Severson-Group/CHP-Gen-Drive-Schematic/README.md

# CHP-Gen-Drive-Schematic
Schematics of generator drive system

Describes interconnects between sub-systems, e.g. interface from AMDC to Semikron power stack.
