Severson-Group/CHP-Gen-Drive-Schematic/DOE_CHP_DriveSystem/Project Outputs for DOE_CHP_DriveSystem/DOE_CHP_DriveSystem_BOM.xlsx

Comment | Description | Designator | Qnty
DIN_PSU_5Vdc |  |  | 1
NMA0515 | Module DC-DC 5VIN 2-OUT 15V/-15V 0.033A/-0.033A 1W 5-Pin SIP Tube |  | 1
DIN_PSU_15Vdc | 15VDC power supply | *1 | 1
AMDS measurement system | AMDS measurement system to be combined with AMDC for motor control | *?, AMDS_1 | 2
DIN_PSU_24Vdc | 24Vdc power supply from 115Vac in | [NoValue], *2, *3, *4 | 4
AMDS_ADC_Curr | AMDS current measurement card | [NoValue], AMDS_Curr_ADC_1 | 2
AMDS_ADC_HV | High voltage measurement card | [NoValue], AMDS_HV_ADC_1 | 2
Wago 260 | 28-16 AWG Spring Clamp Terminal Block - DIN Mountable, 28-16AWG Spring Clamp Terminal Block - DIN Mountable | +1, +2, +24Vdc, 24Vdc -, 24Vdc - _2, 24Vdc +, 24Vdc + _2, Gnd, Gnd1, Gnd2, PWM1, PWM2, PWM3, PWM4, PWM?, Tach1, Tach2, Tach3, Tach4 | 24
Bus Bar | Single Connection bus bar | AC1 (U), AC2 (V), AC3 (W), DC -, DC -1, DC -2, DC -?, DC +, DC +1, DC +2, DC +?, Load, Load1, Phase U, Phase U1, Phase V, Phase V1, Phase W, Phase W1 | 21
AMDC | Advanced Motor Drive Controller | AMDC_1 | 2
AMDS_ADC_LV | Low Voltage measurement card | AMDS LV ADC 1, AMDS LV ADC 2, AMDS LV ADC 3, AMDS LV ADC 4, AMDS_LV_ADC_1 | 5
AWHW20G-SMD | ASSMANN WSW AWHW Series, 2.54mm Pitch 20 Way 2 Row Straight PCB Header, Solder Termination, 3A | BrakeChopperConnector, BrakeChopperConnector1 | 2
09185206813 | ASSMANN WSW AWHW Series, 2.54mm Pitch 20 Way 2 Row Straight PCB Header, Solder Termination, 3A | BrakeChopperMateConnector | 1
Capacitor 1 uF +/- 10% 16 V 0603 | Chip Capacitor, 1 uF, +/- 10%, 16 V, 0603 (1608 Metric) | C1, C2 | 2
2-338069-0 | Conn FFC Connector F 20 POS 2.54mm Solder ST SMD T/R | ControlConnection_X1, ControlConnection_X?, LogicInput_X1 | 3
Molex 22-11-1041 | Headers & Wire Housings 2.5MM VERT 4P HDR W/FRICTION RAMP AU | Current Sense U, Current Sense V, Current Sense W, CurrSense U, CurrSense U2, CurrSense V, CurrSense V2, CurrSense W, CurrSense W2 | 9
Molex 5051-04 | Headers & Wire Housings 2.5MM VERT 4P HDR W/FRICTION RAMP AU | CurrSense U1, CurrSense V1, CurrSense W1 | 3
BZX79C4V7-T50A | Zener Diode, 3.6 V, 5 mA, -65 to 200 degC, 2-Pin DO-35, RoHS, Bulk | D1 | 1
B5819W | Schottky Barrier Rectifier, 40 V, 1 A, -65 to 125 degC, 2-Pin SOD123, RoHS, Tape and Reel | D2, D3 | 2
FAULT | Red LED, 80 mW, 30 mA, -25 to 85 degC, 2-Pin THD | DS1 | 1
Connector 15 | Receptacle Assembly, 15-Pin, Sim Line Connector | J1, J2, J3, J4 | 4
2-215083-0 | Header, 20-Pin | P1 | 1
Semikron_SKS_170F_B6Ci_141_V12_IO | IO connections of Semikron power stack. Intended to route to connectors used on the power stack such that external connecting equipment can be shown in schematic form w/ appropriate mating connector. | PowerStack_1, SemikronPwrStck | 2
MFR-25FBF52-1K | Axial Resistor, 1 KOhm, +/- 1%, 250 mW, -55 to 155 degC, 2-Pin THD, RoHS, Bulk | R1 | 1
4D7R5J | 4R7 0.125W 5% 0805 (2012 Metric) SMD | R2, R3, R4, R5, R7, R8, R9, R10, R11, R12, R13 | 11
MFR-25FBF52-100R | Axial Resistor, 100 Ohm, +/- 1%, 0.25 W, -55 to 155 degC, 2-Pin THD, RoHS, Bulk | R6 | 1
Semikron_BrakeChopper | Integrated buck device w/ heatsink | SemikronBrakeChop, SemikronBrakeChop1 | 2
RESET | Tactile Switch, SPST-NO, 0.05 A, 12 V, -25 to 70 degC, 2-Pin SMD, RoHS, Tape and Reel | SW1 | 1
SN74HC02N | IC Quad 2i/p NOR gate, 74HC02N DIP14 2-6V | U1 | 1
SN74ACT14N | 6-ch, 4.5-V to 5.5-V inverters with Schmitt-Trigger inputs 14-PDIP -40 to 85 | U2 | 1
MCP1407 | Microchip MCP1407-E/P; MOSFET Power Driver 6A; 4.5 to 18V; Non-Inverting; 8-Pin PDIP | U3 | 1
