Severson-Group/CHP-Gen-Drive-Schematic/BoundaryIOP.xlsx

Sheet: Semikron_Stack
Group | Designator | Description | Type | Specification | Connector | Pin | Mating Connector | Wire Gauge | Component P/N | Notes
Fan | +24Vdc | Fan Power | Power | 20.4-27.6 V, 1.5A | Wago 260 | 1 | N/A | 28-16 AWG | SanAce: 9GV1224P1J01
Fan | +24Vdc | Fan Power | Power | 20.4-27.6 V, 1.5A | Wago 260 | 1
Fan | Gnd | Fan Power | Power | Ground | Wago 260 | 2
Fan | Gnd | Fan Power | Power | Ground | Wago 260 | 2
Fan | Tach1 | Fan RPM sense | Output | Open Collector 27.6V, 10mA max, 2 ppRev | Wago 260 | 3 |  |  |  | Connected to AMDC 5v via 1K ohm
Fan | PWM1 | Fan speed control | Input | TTL, 5.25V max, 25KHz, | Wago 260 | 4 |  |  |  | Connected to AMDC 5v via 1K ohm
Fan | Tach2 | Fan RPM sense | Output | Open Collector 27.6V, 10mA max, 2 ppRev | Wago 260 | 5 |  |  |  | Connected to AMDC 5v via 1K ohm
Fan | PWM2 | Fan speec control | Input | TTL, 5.25V max, 25KHz, | Wago 260 | 6 |  |  |  | Connected to AMDC 5v via 1K ohm
DCLink | DC+ | DC Link positive x4 | Power | Abs Max 1,000Vdc | Bus Bar | 2,3,5,6 | 9.5mm bolt
DCLink | DC- | DC link negative x3 | Power |  | Bus Bar | 1,4,7
Phase | AC1 (U) | Phase U connection | Power |  | Bus Bar | 1 | 9mm bolt
Phase | AC2 (V) | Phase V connection | Power |  | Bus Bar | 2
Phase | AC3 (W) | Phase W connection | Power |  | Bus Bar | 3
CT1 (U) | V_ref | Output signal reference | Output | 2.5V +/- 0.025v | Molex KK 2.5mm 4-pin | 1 | Molex PN 5051-04 | 22-30 AWG | LEM Hass-100-S
CT1 (U) | Output (U) | Current sense output (U) | Output | 6.25mV/A + Vref, +/- 0.015 | Molex KK 2.5mm 4-pin | 2
CT1 (U) | 0V | Ground | Power | PS ground | Molex KK 2.5mm 4-pin | 3
CT1 (U) | +5v | Power Supply | Power | 5V +/-5%, 25mA max | Molex KK 2.5mm 4-pin | 4 |  |  |  | Provided by AMDS Daughter Header
CT2 (V) | V_ref | Output signal reference | Output | 2.5V +/- 0.025v | Molex KK 2.5mm 4-pin | 1 | Molex PN 5051-04 | 22-30 AWG | LEM Hass-100-S
CT2 (V) | Output (V) | Current sense output (V) | Output | 6.25mV/A + Vref, +/- 0.015 | Molex KK 2.5mm 4-pin | 2
CT2 (V) | 0V | Ground | Power | PS ground | Molex KK 2.5mm 4-pin | 3
CT2 (V) | +5v | Power Supply | Power | 5V +/-5%, 25mA max | Molex KK 2.5mm 4-pin | 4 |  |  |  | Provided by AMDS Daughter Header
CT3 (W) | V_ref | Output signal reference | Output | 2.5V +/- 0.025v | Molex KK 2.5mm 4-pin | 1 | Molex PN 5051-04 | 22-30 AWG | LEM Hass-100-S
CT3 (W) | Output (W) | Current sense output (W) | Output | 6.25mV/A + Vref, +/- 0.015 | Molex KK 2.5mm 4-pin | 2
CT3 (W) | 0V | Ground | Power | PS ground | Molex KK 2.5mm 4-pin | 3
CT3 (W) | +5v | Power Supply | Power | 5V +/-5%, 25mA max | Molex KK 2.5mm 4-pin | 4 |  |  |  | Provided by AMDS Daughter Header
Control Connection X1 | IF_PWR_VP | Gate Drive Power Supply Positive | Power | 15V +/- 4% | Tyco Micromatch 20 pin | 1 | Tyco PN 2-215083-0 | 28 AWG Ribbon
Control Connection X1 | IF_PWR_VP | Gate Drive Power Supply Positive | Power | 15V +/- 4% |  | 2 |  |  |  | Provided by AMDC Pass Through
Control Connection X1 | IF_CMN_DCLINK_P | Differential DC Link V sense Positive | Output | 0-10V, 3mV/V, +/- 2.5% |  | 3
Control Connection X1 | IF_CMN_DCLINK_N | Differential DC Link V sense Negative | Output |  |  | 4
Control Connection X1 | - | Not Used |  |  |  | 5
Control Connection X1 | - | Not Used |  |  |  | 6
Control Connection X1 | IF_CMN_GND | Gate Drive & PWM Ground | Power | Ground |  | 7
Control Connection X1 | IF_CMN_HB1_TOP | Gate Signal, TOP, Phase U | Input | 15V CMOS Input |  | 8
Control Connection X1 | IF_CMN_HB1_BOT | Gate Signal, BOT, Phase U | Input | 15V CMOS Input |  | 9
Control Connection X1 | IF_CMN_HB2_TOP | Gate Signal, TOP, Phase V | Input | 15V CMOS Input |  | 10
Control Connection X1 | IF_CMN_HB2_BOT | Gate Signal, BOT, Phase V | Input | 15V CMOS Input |  | 11
Control Connection X1 | IF_CMN_HB3_TOP | Gate Signal, TOP, Phase W | Input | 15V CMOS Input |  | 12
Control Connection X1 | IF_CMN_HB3_BOT | Gate Signal, BOT, Phase W | Input | 15V CMOS Input |  | 13
Control Connection X1 | IF_CMN_GND | Gate Drive & PWM Ground | Power | Ground |  | 14
Control Connection X1 | IF_CMN_ERR | Gate Driver error output | Output | Open collector, LOW = ERROR, max 30mA |  | 15
Control Connection X1 | - | Not Used |  |  |  | 16
Control Connection X1 | - | Not Used |  |  |  | 17
Control Connection X1 | - | Not Used |  |  |  | 18
Control Connection X1 | IF_CMN_GND | Gate Drive & PWM Ground | Power | Ground |  | 19
Control Connection X1 | IF_CMN_GND | Gate Drive & PWM Ground | Power | Ground |  | 20

Sheet: Semikron_Chopper
Group | Designator | Description | Type | Specification | Connector | Pin | Mating Connector | Wire Gauge | Component P/N | Notes
DC link | 1- | Negative DC link connection, Anode of diode | Power_In | abs max 1,200V, 652A | M6 - 2.5-5Nm, 6.5-10mm length | 1 | M6 8mm bolt |  | SEMiX703GAR126HDs
DC link | 2+ | Positive DC link connection, Drain/Collector of switching device. | Power_In | abs max 1,200V, 652A | M6 - 2.5-5Nm, 6.5-10mm length | 2 | M6 8mm bolt
Load | 3 | AC link connection/Resitive load connection, Emitter of switching device/Cathode of diode | Power_Out |  | M6 - 2.5-5Nm, 6.5-10mm length | 3 | M6 8mm bolt
Load | 4 | same as Load 3 | Power_Out |  | M6 - 2.5-5Nm, 6.5-10mm length | 4 | M6 8mm bolt
Control - X20 | IF_PWR_15P | Drive Power Supply | Power_In | +15V +/-45% | Assmann AWHW 20G SMD | 1 | 09185206813 | 20 x AWG 26-28 Ribbon | 3s SKYPER 32 PRO R Gold | Provided by AMDC Pass Through
Control - X20 | IF_PWR_GND | Ground for power supply | Power_In | Gnd |  | 2
Control - X20 | IF_PWR_15P | Drive Power Supply | Power_In | +15V +/-45% |  | 3
Control - X20 | IF_PWR_GND | Ground for power supply | Power_In | Gnd |  | 4
Control - X20 | IF_PWR_15P | Drive Power Supply | Power_In | +15V +/-45% |  | 5
Control - X20 | IF_PWR_GND | Ground for power supply | Power_In | Gnd |  | 6
Control - X20 | reserved |  | - | - |  | 7
Control - X20 | IF_PWR_GND | Ground for power supply | Power_In | Gnd |  | 8
Control - X20 | IF_CMN_nHALT | Drive core status signal (Bidirectional signal w/ dominant recessive behavior) | I/O | Digital 15V logic. LOW(dominant) = driver disabled. HIGH(recessive) = ready to operate |  | 9
Control - X20 | reserved | - | - | - |  | 10
Control - X20 | reserved | - | - | - |  | 11
Control - X20 | IF_CMN_GND | Ground for signal IF_CMN_nHALT | I/O | Gnd for nHalt |  | 12
Control - X20 | reserved | - | - | - |  | 13
Control - X20 | reserved | - | - | - |  | 14
Control - X20 | IF_HB_TOP | Switching signal input (TOP switch) | Input | Digital 15V logic. 10Kohm impedance. LOW = TOP switch off |  | 15
Control - X20 | IF_HB_BOT | Switching signal input (BOT switch) | Input | Digital 15V logic. 10Kohm impedance. LOW = BOT switch off |  | 16
Control - X20 | reserved | - | - | - |  | 17
Control - X20 | IF_HB_GND | Ground for signals IF_HB_TOP and IF_HB_BOT | Input | Ground for gate signals |  | 18
Control - X20 | reserved | - | - | - |  | 19
Control - X20 | reserved | - | - | - |  | 20

Sheet: AMDC
Group | Designator | Description | Type | Specification | Connector | Pin | Mating Connector | Wire Gauge | Component P/N | Notes
Power | Vin | +24Vdc AMDC Logic Power | Power_In | 20-34Vdc, 0.5A | 1x2 screw terminal | 1 | N/A | 12-26AWG
Power | Gnd_In | Ground | Power | Ground, isolated |  | 2
Vdrive | Vdrive | PWM voltage source positive | Power_In | 5-18Vdc | 1x2 screw terminal | 1 | N/A | 12-26AWG
Vdrive | Gnd_drive | PWM voltage source gnd | Power | Ground |  | 2
Vps | Vps | Gate Driver PS Positive- Pass through | Power_In | 2A max | 1x2 screw terminal | 1 | N/A | 12-26AWG
Vps | Gnd_ps | Gate Driver PS Ground - pass through | Power | Ground |  | 2
Estop | Estop_out | E-stop sense line out | Output | closed ckt, drive enabled | 1x2 screw terminal | 1 | N/A | 12-26AWG
Estop | Estop_in | E-stop sense line In | Input |  |  | 2
InverterCntrl1 | INV1_PWM1 | Inverter 1 PWM output 1 | Output | PWM bridge signal, level determined by Vdrive | 3 Row DB-15 - Female | 1 | 3 Row DB-15 Male | 24-28 AWG |  | Rinse Repeat x8
InverterCntrl1 | INV1_PWM2 | Inverter 1 PWM output 2 | Output | PWM bridge signal, level determined by Vdrive |  | 2 |  |  |  | Top is odd, Bottom is Even on stacked DB-15
InverterCntrl1 | INV1_PWM3 | Inverter 1 PWM output 3 | Output | PWM bridge signal, level determined by Vdrive |  | 3
InverterCntrl1 | INV1_PWM4 | Inverter 1 PWM output 4 | Output | PWM bridge signal, level determined by Vdrive |  | 4
InverterCntrl1 | INV1_PWM5 | Inverter 1 PWM output 5 | Output | PWM bridge signal, level determined by Vdrive |  | 5
InverterCntrl1 | INV1_PWM6 | Inverter 1 PWM output 6 | Output | PWM bridge signal, level determined by Vdrive |  | 6
InverterCntrl1 | Gnd | Inverter PWM ground reference | Power_Out | Vdrive ground |  | 7
InverterCntrl1 | STS_A_1 | Inverter Status A | I/O | 3.3 or 5v Vdd ref, can be set as Input or Output |  | 8 |  |  |  | Single jumper det'ns I or O for A-D
InverterCntrl1 | STS_B_1 | Inverter Status B | I/O | 3.3 or 5v Vdd ref, can be set as Input or Output |  | 9
InverterCntrl1 | STS_C_1 | Inverter Status C | I/O | 3.3 or 5v Vdd ref, can be set as Input or Output |  | 10
InverterCntrl1 | STS_D_1 | Inverter Status D | I/O | 3.3 or 5v Vdd ref, can be set as Input or Output |  | 11
InverterCntrl1 | Vps | Gate driver PS positive | Power_In | 2A max |  | 12
InverterCntrl1 | Vdd | Status reference V output | Power_Out | Set either 3.3 or 5V via jumper |  | 13
InverterCntrl1 | Gnd_ps | Gate driver PS Ground | Power_In | Ground |  | 14
InverterCntrl1 | Gnd | Status reference V output Gnd | Power_Out | Status ref ground |  | 15
Analog1 | Analog_P1 | Differential Analog ADC Positive input 1 | Input | +/-10V differential signal | RJ-45 - Female | 1 | RJ45 - Male | 22-24 AWG |  | Rinse Repeat x4
Analog1 | Analog_N1 | Differential Analog ADC Negative input 1 | Input |  |  | 2
Analog1 | Vanalog_P | +15V analog measurement positive voltage | Power_Out | +15Vdc reference signal from AMDC |  | 3
Analog1 | Gnd | Ground | Power_Out | analog measurement power ground |  | 4
Analog1 | Vanalog_N | -15V analog measurement negative voltage | Power_Out | -15Vdc reference signal from AMDC |  | 5
Analog1 | Gnd | Ground | Power_Out | analog measurement power ground |  | 6
Analog1 | Analog_P2 | Differential Analog ADC Positive input 2 | Input | +/-10V differential signal |  | 7
Analog1 | Analog_N2 | Differential Analog ADC Negative input 2 | Input |  |  | 8
Encoder1 | A | Differential encoder A positive | Input | 0-5V unipolar | DB9 - Female | 1 | DB9 - Male | 24-28 AWG |  | Rinse Repeat x2
Encoder1 | !A | Differential encoder A negative | Input |  |  | 2
Encoder1 | B | Differential encoder B positive | Input | 0-5V unipolar |  | 3
Encoder1 | !B | Differential encoder B negative | Input |  |  | 4
Encoder1 | Z | Differential encoder Z positive | Input | 0-5V unipolar |  | 5
Encoder1 | !Z | Differential encoder Z negative | Input |  |  | 6
Encoder1 | 5V | Optional +5V encoder power | Power_Out | Short JP2/JP3 to enable power to Encoder1 or 2 |  | 7
Encoder1 | GND | encoder ground | Power_Out |  |  | 8
Encoder1 | GND | encoder ground | Power_Out |  |  | 9
GPIO1 | +5V |  | Power_Out | +5Vdc output | 3 Row DB-15 - Female | 1 | 3 Row DB-15 Male | 24-28 AWG |  | Rinse Repeat x4
GPIO1 | GPIO1_IN1_P | Differential GPIO In1 positive | Input | 0-5V unipolar |  | 2
GPIO1 | GPIO1_IN1_N | Differential GPIO In1 negative | Input |  |  | 3
GPIO1 | GPIO1_IN2_P | Differential GPIO In2 positive | Input | 0-5V unipolar |  | 4
GPIO1 | GPIO1_IN2_N | Differential GPIO In2 negative | Input |  |  | 5
GPIO1 | +24V |  | Power_Out | +24Vdc output |  | 6
GPIO1 | GPIO1_IN3_P | Differential GPIO In3 positive | Input | 0-5V unipolar |  | 7
GPIO1 | GPIO1_IN3_N | Differential GPIO In3 negative | Input |  |  | 8
GPIO1 | GPIO1_OUT3_P | Differential GPIO Out3 positive | Output | 0-5V unipolar |  | 9
GPIO1 | GPIO1_OUT3_N | Differential GPIO Out3 negative | Output |  |  | 10
GPIO1 | Gnd |  | Power_Out |  |  | 11
GPIO1 | GPIO1_OUT1_P | Differential GPIO Out1 positive | Output | 0-5V unipolar |  | 12
GPIO1 | GPIO1_OUT1_N | Differential GPIO Out1 negative | Output |  |  | 13
GPIO1 | GPIO1_OUT2_P | Differential GPIO Out2 positive | Output | 0-5V unipolar |  | 14
GPIO1 | GPIO1_OUT2_N | Differential GPIO Out2 negative | Output |  |  | 15
JTAG/UART | JTAG_UART | JTAG & UART combo interface | I/O | USB | USB-B | - | USB
Ethernet | ETHERNET | Ethernet expansion | I/O | Ethernet | RJ45 - Female | - | RJ-45 - Male

Sheet: AMDS
Group | Designator | Description | Type | Specification | Connector | Pin | Mating Connector | Wire Gauge | Component P/N | Notes
Power | +24V | Main board positive power | Power_In | 18-36V in | 1x2 screw terminal | 1 |  | 12-26AWG
Power | Gnd | Main board ground power | Power_In | Gnd |  | 2
COMM | 5V_in | Isolated supply voltage | Power_In | 4.5-5.5V | DB 15 - 3 row - Female | 1 | DB 15 - 3 Row - Male | 24-28 AWG |  | *Uart 1 is ADC sync
COMM | UART1_PKT_Rtrn_P | Return ADC data 1 from AMDS to AMDC, diff output, P | Output | 0-5V_in |  | 2 |  |  |  | *Uart 2 is Data Tx
COMM | UART1_PKT_Rtrn_N | Return ADC data 1 from AMDS to AMDC, diff output, N | Output | 0-5V_in |  | 3
COMM | UART2_PKT_Rtrn_P | Return ADC data 2 from AMDS to AMDC, diff output, P | Output | 0-5V_in |  | 4
COMM | UART2_PKT_Rtrn_N | Return ADC data 2 from AMDS to AMDC, diff output, P | Output | 0-5V_in |  | 5
COMM | - | No connection |  |  |  | 6
COMM | isoSPI2_P | Not Used: iso SPI 2 differential input, Positive | I/O | 0-5V_in |  | 7
COMM | isoSPI2_N | Not Used: iso SPI 2 differential input, Negative | I/O | 0-5V_in |  | 8
COMM | isoSPI3_P | Not Used: iso SPI 3 differential input, Positive | I/O | 0-5V_in |  | 9
COMM | isoSPI3_N | Not Used: iso SPI 3 differential input, Negative | I/O | 0-5V_in |  | 10
COMM | GND | Ground | Power_In | 0V |  | 11
COMM | ADC_Sync_P | ADC Sync differential input, Positive | Input | +/- 0-12V, 54-60Ohm |  | 12
COMM | ADC_Sync_N | ADC Sync differential input, Negative | Input | +/- 0-12V, 54-60Ohm |  | 13
COMM | UART_Pkt_Req_P | UART PKT Sync differential input, Positive | Input | +/- 0-12V, 54-60Ohm |  | 14
COMM | UART_Pkt_Req_N | UART PKT Sync differential input, Negative | Input | +/- 0-12V, 54-60Ohm |  | 15
GPIO | 3v3 | 3.3v GPIO voltage out | Power_Out |  | DB 15 - 3 row - Female | 1 | DB 15 - 3 Row - Male | 24-28 AWG
GPIO | GPIO_1 | GPIO | I/O | 3.0-3.6V |  | 2
GPIO | GPIO_2 | GPIO | I/O | 3.0-3.6V |  | 3
GPIO | GPIO_3 | GPIO | I/O | 3.0-3.6V |  | 4
GPIO | GPIO_4 | GPIO | I/O | 3.0-3.6V |  | 5
GPIO | GPIO_5 | GPIO | I/O | 3.0-3.6V |  | 6
GPIO | GPIO_6 | GPIO | I/O | 3.0-3.6V |  | 7
GPIO | GPIO_7 | GPIO | I/O | 3.0-3.6V |  | 8
GPIO | GPIO_8 | GPIO | I/O | 3.0-3.6V |  | 9
GPIO | GPIO_9 | GPIO | I/O | 3.0-3.6V |  | 10
GPIO | GPIO_10 | GPIO | I/O | 3.0-3.6V |  | 11
GPIO | GPIO_11 | GPIO | I/O | 3.0-3.6V |  | 12
GPIO | GPIO_12 | GPIO | I/O | 3.0-3.6V |  | 13
GPIO | GND | Ground | Power_Out |  |  | 14
GPIO | GND | Ground | Power_Out |  |  | 15
DC1 | +15V | Daughter card +15v power | Power_In | +15Vdc +/-5% LV25 supply signal | 1x3 pin header | 1 | 1x3 pin header | board 2 board |  | total of 8 Daughter cards
DC1 | Gnd | Daughter card power gnd | Power_In | ground |  | 2
DC1 | -15V | Daughter card -15V power | Power_In | -15Vdc +/-5% LV25 supply signal |  | 3
DC1 | 5V | Daughter card 5V power | Power_Out | 5v | 1x7 pin header | 1 | 1x7 pin header | board 2 board
DC1 | 3v3 | Daughter card 3v3 power | Power_Out | 3.3v |  | 2
DC1 | GND | Daughter card gnd | Power_Out | ground |  | 3
DC1 | DIN | Daughter card serial comm in | Input | 3.3v max Spi data in |  | 4
DC1 | DOUT | Daughter card serial comm out | Output | 3.3v, Spi data out |  | 5
DC1 | SCLK | Daughter card serial comm clk | Output | 3.3v max, Spi clock Out |  | 6
DC1 | CONVST | Daughter card ADC conversion trigger | Output | 3.3v max, ADC start conv trig |  | 7

Sheet: LV ADC Card
Group | Designator | Description | Type | Specification | Connector | Pin | Mating Connector | Wire Gauge | Component P/N | Notes
Power | +15v | +15v External connection | Power_In | +15Vdc reference signal | 1x3 screw terminal | 1
Power | Gnd | Gnd, External connection | Power_In | ground |  | 2
Power | -15V | -15v External connection | Power_In | -15Vdc reference signal |  | 3
Power | +15v | +15v Native AMDS connection | Power_In | +15Vdc reference signal | 1x3 pin header | 1 |  |  |  | Duplicate w/ alternate connection
Power | Gnd | Gnd, Native AMDS connection | Power_In | ground |  | 2 |  |  |  | +/-15Vdc provided by AMDS
Power | -15V | -15v Native AMDS connection | Power_In | -15Vdc reference signal |  | 3
ADMCIntr | 5V | ADC reference 5V signal - fed into 4.096v ref | Power_In | 5v | 1x7 pin header | 1
ADMCIntr | 3v3 | ADC reference 3.3v signal - fed into 2.048v ref | Power_In | 3.3v |  | 2
ADMCIntr | Gnd | ground ADC comm ref | Power_In | ground |  | 3
ADMCIntr | Din | Digital in | Input | 3.3v max Spi data in |  | 4
ADMCIntr | Sysclk | sysclock | Input | 3.3v max, Spi clock in |  | 5
ADMCIntr | Dout | Digital out | Output | 3.3v, Spi data out |  | 6
ADMCIntr | Convst | ADC sync trigger | Input | 3.3v max, ADC start conv trig |  | 7
Signal | Vin+ | Voltage signal of interest, positive | Input | +/- 15.4v max | 1x2 screw terminal | 1 |  |  |  | ADC val out = 0.1(Vin+ - Vin-)+2.048v
Signal | Vin- | Voltage signal of interest, negative | Input | +/- 15.4v max |  | 2 |  |  |  | Max differential voltage +/- 10v
Signal | Vin+ | Voltage signal of interest, positive | Input | +/- 15.4v max | BNC | 1 |  |  |  | Duplicate w/ alternate connection
Signal | Vin- | Voltage signal of interest, negative | Input | +/- 15.4v max |  | 2

Sheet: HV ADC Card
Group | Designator | Description | Type | Specification | Connector | Pin | Mating Connector | Wire Gauge | Component P/N | Notes
Power | +15v | +15v External connection | Power_In | +15Vdc +/-5% LV25 supply signal | 1x3 screw terminal | 1
Power | Gnd | Gnd, External connection | Power_In | ground |  | 2
Power | -15V | -15v External connection | Power_In | -15Vdc +/-5% LV25 supply signal |  | 3
Power | +15v | +15v Native AMDS connection | Power_In | +15Vdc +/-5% LV25 supply signal | 1x3 screw terminal | 1 |  |  |  | Duplicate w/ alternate connection
Power | Gnd | Gnd, Native AMDS connection | Power_In | ground |  | 2 |  |  |  | +/-15Vdc provided by AMDS
Power | -15V | -15v Native AMDS connection | Power_In | -15Vdc +/-5% LV25 supply signal |  | 3
ADMCIntr | 5V | ADC reference 5V signal - fed into 4.096v ref | Power_In | 5v | 1x7 pin header | 1
ADMCIntr | 3v3 | ADC reference 3.3v signal - fed into 2.048v ref | Power_In | 3.3v |  | 2
ADMCIntr | Gnd | ground ADC comm ref | Power_In | ground |  | 3
ADMCIntr | Din | Digital in | Input | 3.3v max Spi data in |  | 4
ADMCIntr | Sysclk | sysclock | Input | 3.3v max, Spi clock in |  | 5
ADMCIntr | Dout | Digital out | Output | 3.3v, Spi data out |  | 6
ADMCIntr | Convst | ADC sync trigger | Input | 3.3v max, ADC start conv trig |  | 7
Signal | Vin+ | Voltage signal of interest, positive | Input | +/- 500v | Lug terminal | 1 |  |  | LV25-p
Signal | Vin- | Voltage signal of interest, negative | Input | +/- 500v | Lug terminal | 1 |  |  |  | Max differential voltage = +/- 500V

Sheet: Current ADC Card
Group | Designator | Description | Type | Specification | Connector | Pin | Mating Connector | Wire Gauge | Component P/N | Notes
Power | +15v | +15v External connection | Power_In | +15Vdc +/-5% LA55 supply signal | 1x3 screw terminal | 1
Power | Gnd | Gnd, External connection | Power_In | ground |  | 2
Power | -15V | -15v External connection | Power_In | -15Vdc +/-5% LA55 supply signal |  | 3
Power | +15v | +15v Native AMDS connection | Power_In | +15Vdc +/-5% LA55 supply signal | 1x3 screw terminal | 1 |  |  |  | Duplicate w/ alternate connection
Power | Gnd | Gnd, Native AMDS connection | Power_In | ground |  | 2 |  |  |  | +/-15Vdc provided by AMDS
Power | -15V | -15v Native AMDS connection | Power_In | -15Vdc +/-5% LA55 supply signal |  | 3
ADMCIntr | 5V | ADC reference 5V signal - fed into 4.096v ref | Power_In | 5v | 1x7 pin header | 1
ADMCIntr | 3v3 | ADC reference 3.3v signal - fed into 2.048v ref | Power_In | 3.3v |  | 2
ADMCIntr | Gnd | ground ADC comm ref | Power_In | ground |  | 3
ADMCIntr | Din | Digital in | Input | 3.3v max Spi data in |  | 4
ADMCIntr | Sysclk | sysclock | Input | 3.3v max, Spi clock in |  | 5
ADMCIntr | Dout | Digital out | Output | 3.3v, Spi data out |  | 6
ADMCIntr | Convst | ADC sync trigger | Input | 3.3v max, ADC start conv trig |  | 7
Signal | Ip+ | Voltage signal of interest, positive | Input | +/- 55Arms (P5) | Lug terminal | 1 |  |  | LA55-p | 1/7 V/A w/ 2.35V bias
Signal | Ip- | Voltage signal of interest, negative | Input | +/- 55Arms (P6) | Lug terminal | 1 |  |  |  | Max current +/-55Arms

Sheet: External PSUs
Component | Voltage | Power | Qnty | Description
AMDC | 24V | <24w |  | Main Logic Power
 | 15V | 15-30w |  | PWM power & Power stack gate drive power pass through
AMDS | 24V | <24w |  | Main Logic Power
Semikron Power stack | 24V | 36w | 2 | Fan power
Semikron Chopper | 15V | 31.5W

Sheet: BOM
Line | Component | Where Used | Status | Mating Connector | Qnty | Supplier Link
10 | TE Connectivity - 2-338069-0 | Semikron Stack gate drive | Received | 2-215083-0 | 1 | https://www.newark.com/amp-te-connectivity/2-215083-0/wtb-conn-header-20pos-2row-1-27mm/dp/23AH0110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
20 | Molex 22-11-1041 | Semikron stack curr sense | Received | 22-01-1042 | 3 | https://www.newark.com/molex/22-01-1042/connector-rcpt-4pos-1row-2-5mm/dp/55H8852?st=22-01-1042
 | LEM Hass-100-S | Semikron stack curr sense | Received | KK 254 Crimp Terminal, 22-30 AWG, Hot Tin (Sn) Dip Plating | 12 | https://www.newark.com/molex/08-50-0114/contact-socket-22awg-crimp/dp/34H3328?MER=sy-me-pd-mi-acce
30 | DC link Power Interface | Semikron Stack | Common Stocked Parts | 9.5mm OD bolt | 7
40 | DC link Power Interface | Semikron Stack | Common Stocked Parts | 9.5mm nut | 7
50 | Phase Power Interface | Semikron Stack | Common Stocked Parts | 9mm Bolt | 3
60 | Phase Power Interface | Semikron Stack | Common Stocked Parts | 9mm nut | 3
70 | Assmann AWHW 20G SMD | Semikron Chopper | Received | 09185206813 | 1 | https://www.newark.com/harting/09185206813/wire-board-connector-female-20/dp/88K2091?ost=09185206813
80 | Power Interface | Semikron Chopper | Common Stocked Parts | M6x8mm bolt | 4
90 | 1m DIN rail | Cabinet | PurReq Sent |  | 1 | https://www.newark.com/weidmuller/0514500000/din-mounting-rail-35mm-x-7-5mm/dp/13P0027
100 | 15V 20W DIN PSU | PWM & Gate drive | PurReq Sent |  | 1 | https://www.newark.com/xp-power/drc30us15/power-supply-ac-dc-15v-2a/dp/82AH6292
110 | 24V 36W DIN PSU | Fans, AMDC & AMDS power | PurReq Sent |  | 4 | https://www.newark.com/xp-power/drc30us24/power-supply-ac-dc-24v-1-5a/dp/82AH6293

Sheet: Interconnect Tracker
 | Connector | Connects to | AWG | Wire Capacity | Voltage | Application Current | HV > 50Vdc
Semikron Stack | Fan | AMDC GPIO1 | 20 | 11 | LV | 1.5 | LV < 50Vdc
 | Fan 24V | PSU 24v 1 & 2 | 24 | 3.5 | LV | Logic
 | DC Link | Chopper | 7 | 89 | HV | 85
 | Phase | Generator | 13 | 35 | HV | 35
 | CT1 (U) | AMDS LVana1 | 24 | 3.5 | LV | Logic
 | CT2 (V) | AMDS LVana3 | 24 | 3.5 | LV | Logic
 | CT3 (W) | AMDS LVana4 | 24 | 3.5 | LV | Logic
 | Control Connection X1 - Control | AMDC Inverter1 | 24 | 3.5 | LV | Logic
 | Control Connection X1 - DC link V | AMDS LVana4 | 24 | 3.5 | LV | Logic
AMDC | 24V Power | PSU 24v 3 | 20 | 11 | LV | <1
 | PWM Power | PSU 15v 1 | 20 | 11 | LV | <1
 | Gate drive power | PSU 15v 1 | 20 | 11 | LV | <1
 | Inverter 1 | Stack - Control | 24 | 3.5 | LV | <1
 | Inverter 5 | Chopper - Control | 24 | 3.5 | LV | <1
 | GPIO 1 | Stack - Fan Control | 24 | 3.5 | LV | <1
AMDS | 24V power | PSU 24v 4 | 20 | 11 | LV | <1
 | AMDS LVana1 | Stack - CT1(U) | 24 | 3.5 | LV | <1
 | AMDS LVana3 | Stack - CT2(V) | 24 | 3.5 | LV | <1
 | AMDS LVana4 | Stack - CT3(W) | 24 | 3.5 | LV | <1
 | AMDS LVana2 | Stack - DC Link Sense | 24 | 3.5 | LV | <1
Semikron Chopper | Control | AMDC Inverter5 | 24 | 3.5 | LV | <1
 | DC Link | Stack - DC Link Power | 7 | 89 | HV | 85
 | Load | Load Bank | 7 | 89 | HV | 85
DC Link Voltage Monitor | DC Link Monitor | DC Link | 24 | 3.5 | HV | <1

Sheet: Power Calcs
Cable Sizing | Power | 10000 | 30000 | 50000 | w
 | Phase voltage (rms) | 480 | 480 | 480 | vac
 | phase current (rms) | 6.94 | 20.83 | 34.72 | Aac
 | DC link Voltage | 600 | 600 | 601 | Vdc
 | DC link Current | 16.67 | 50.00 | 83.19 | Adc

Sheet: Polaris Resistor
Group | Designator | Description | Type | Specification | Connector | Pin | Mating Connector | Wire Gauge | Component P/N | Notes
