Severson-Group/CHP-Gen-Drive-Schematic/DOE_CHP_DriveSystem/CHP-Gen-Drive-Schematic.pdf

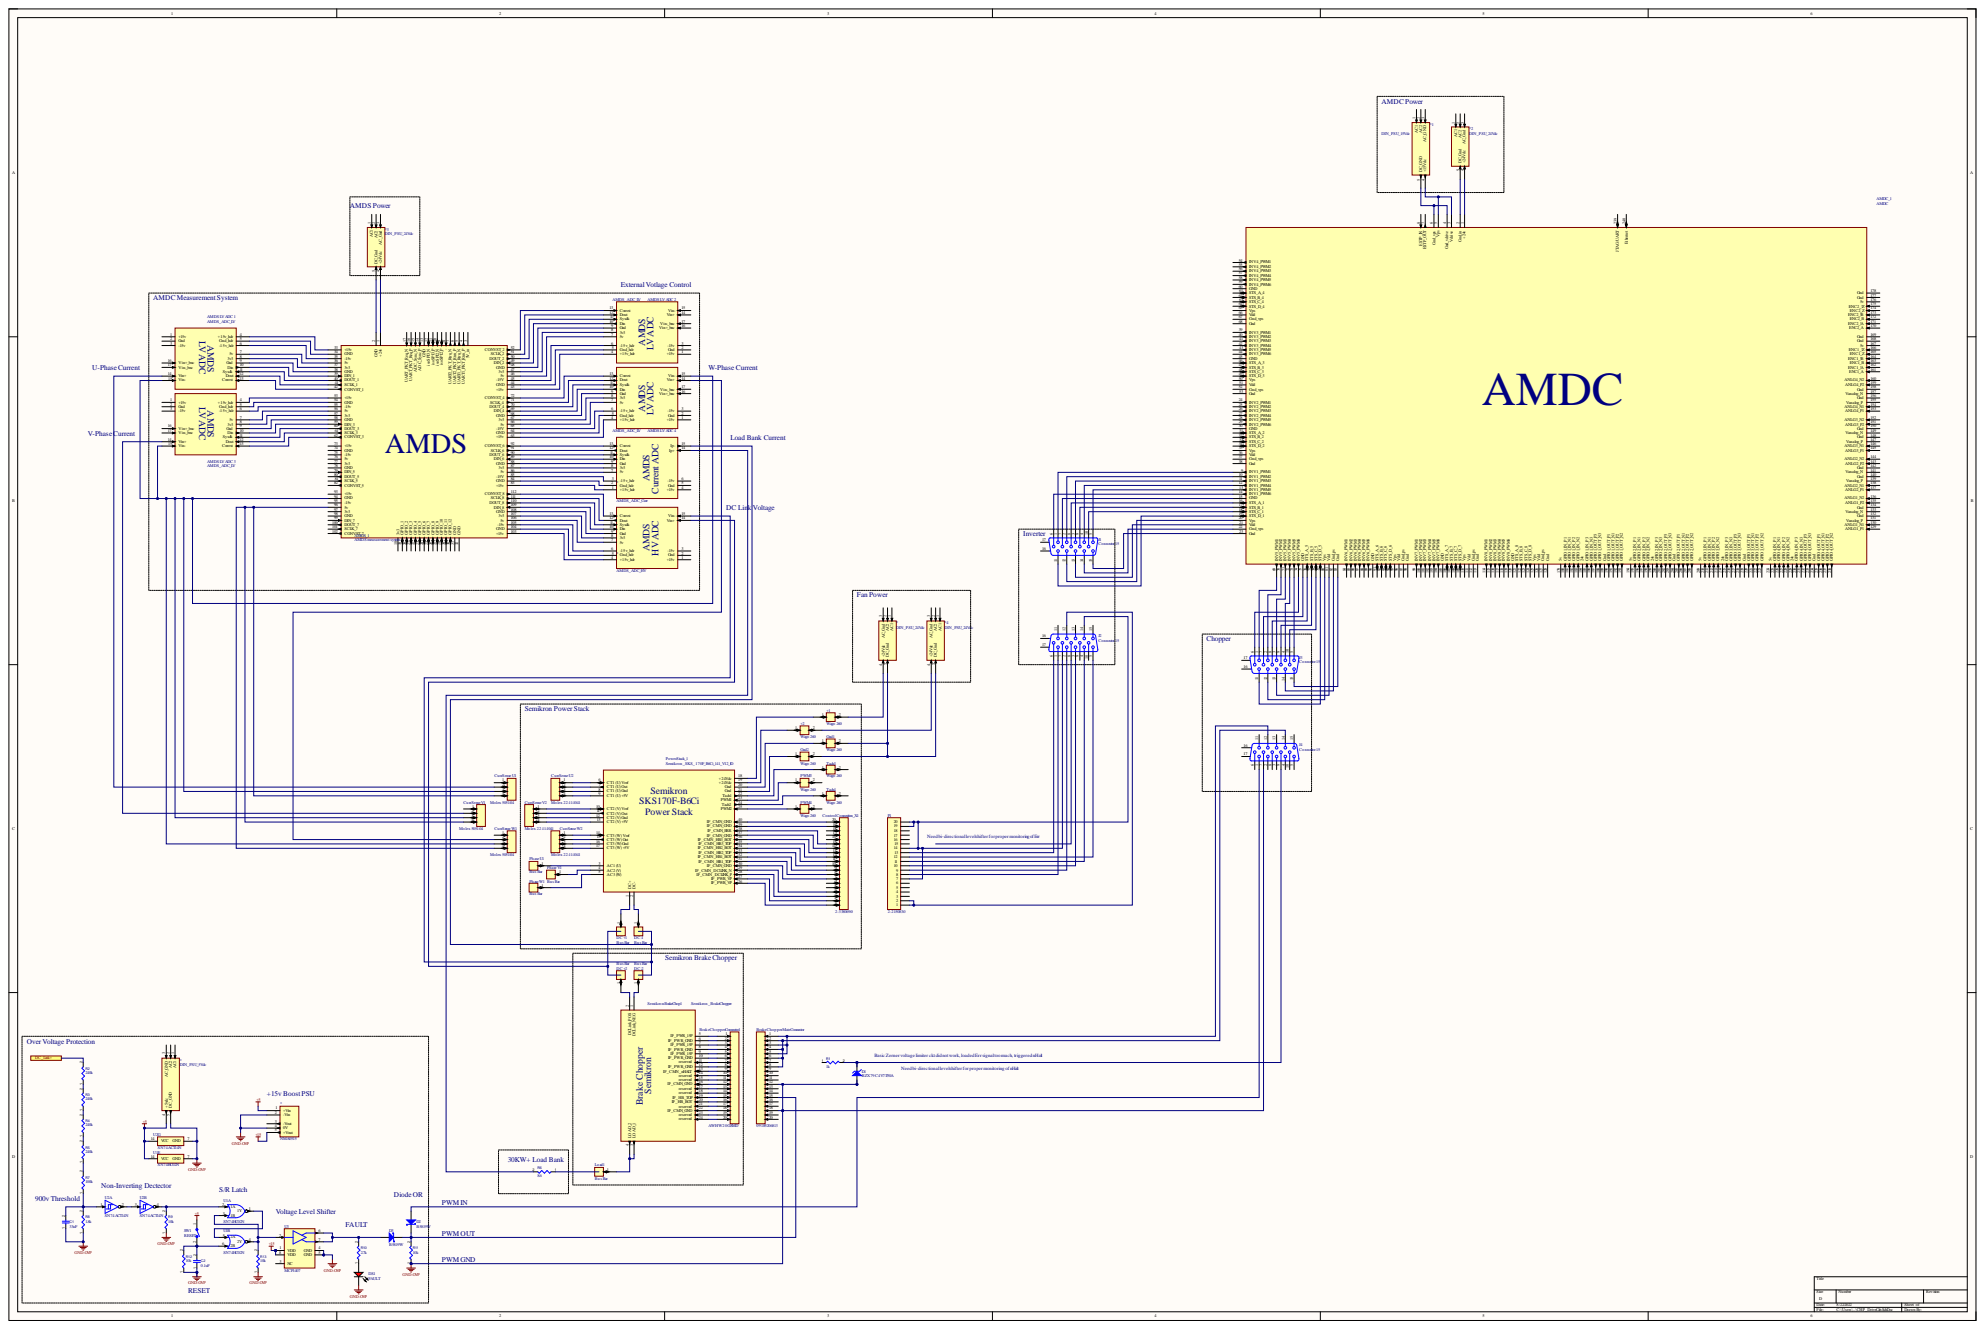
[picture p1: page 1]

AMDS LVADC AMDSLV ADC 1
AMDS_ADC_LV

AMDS LV ADC AMDSLV ADC 3 AMDS_ADC_LV

Need bi-directionallevelshifter for proper monitoring of Err

Basic Zerner voltage limiter cktdid notwork, loaded Errsignaltoo much, triggered nHalt

Need bi-directionallevelshifter for proper monitoring of nHalt
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
