Severson-Group/CHP-Gen-Drive-Schematic/(list of files, drawings)

Other design files:
DOE_CHP_DriveSystem/__Semikron_SKS_170F_B6Ci_141_V12.SchDoc
DOE_CHP_DriveSystem/AMDC.SchDoc
DOE_CHP_DriveSystem/AMDS.SchDoc
DOE_CHP_DriveSystem/CHP_DriveCab.SchDoc
DOE_CHP_DriveSystem/DOE_CHP_DriveSystem.PrjPcb
DOE_CHP_DriveSystem/Semikron_BrakeChopper.SchDoc
DOE_CHP_DriveSystem/Semikron_SKS-170F-B6Ci-141-V12_.SchLib
DOE_CHP_DriveSystem/Semikron_SKS_170F_B6Ci_141_V12.SchDoc
