Severson-Group/CHP-Gen-Drive-Schematic/(commit log)

2022-08-19 Initial commit of schematic project
    [AMDC.SchDoc, AMDS.SchDoc, CHP_DriveCab.SchDoc, DOE_CHP_DriveSystem.PrjPcb, Semikron_BrakeChopper.SchDoc, Semikron_SKS-170F-B6Ci-141-V12_.SchLib, Semikron_SKS_170F_B6Ci_141_V12.SchDoc, __Semikron_SKS_170F_B6Ci_141_V12.SchDoc]
2022-08-19 Update Over Voltage Protection system. Update Chopper control interface - remove low side PWM, remove fault detection line - req's level shifter circuit.
    [CHP_DriveCab.SchDoc]
2022-08-19 Labeled OVP system Removed Fan PWM inputs
    [CHP_DriveCab.SchDoc]
2022-08-19 removed fan control corrected powerstack error interface - req's level shifter circuit
    [CHP_DriveCab.SchDoc]
2022-08-19 Clean up wiring. Add labels & descriptions
    [CHP_DriveCab.SchDoc]
2022-08-19 Fix label error
    [CHP_DriveCab.SchDoc]
2022-08-22 Update smart PDF schematic export
    [CHP_DriveCab.SchDoc, DOE_CHP_DriveSystem.PrjPcb]
2022-08-22 Annotate schematic, label OVP IO, export BOM, export schematic pdf.
    [CHP_DriveCab.SchDoc, DOE_CHP_DriveSystem.PrjPcb, DOE_CHP_DriveSystem_BOM.xlsx]
2022-08-23 Schematic Update
    [DOE_CHP_DriveSystem.PrjPcb]
2022-08-24 Include BOM
    [DOE_CHP_DriveSystem_BOM.xlsx]
2022-08-25 Added Boundary IO document to project. This document describes all interconnects within the system, their connectors, the wire gauge used, and the anticipated voltage and current ratings required.
    [BoundaryIOP.xlsx]
